LbZ7777777/ECE_1895_Bop-It_Project/README.md

ECE 1895 Junior Design Coursework for the University of Pittsburgh
Bop-it Project
