LbZ7777777/ECE_1895_Bop-It_Project/4-12-2025 Enclosure Design/Speaker Mount-Body.stl

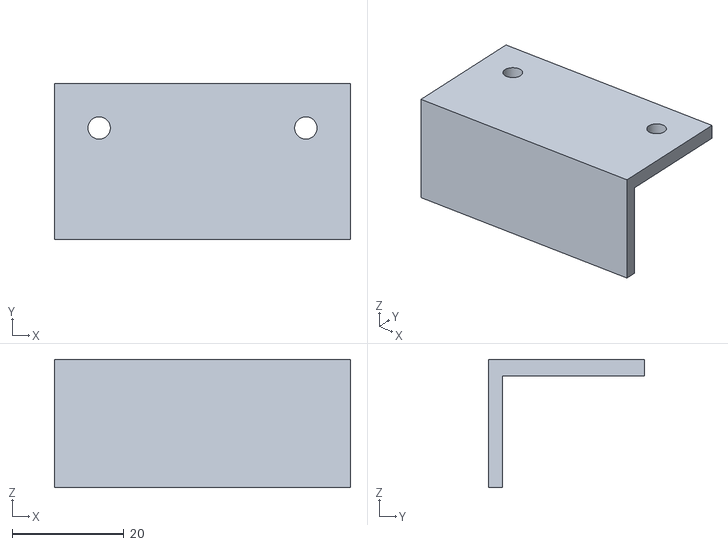
[picture p4: CAD file, 2025-04-13]
4-12-2025 Enclosure Design/Speaker Mount-Body.stl
53.0 x 28.0 x 23.0
