LbZ7777777/ECE_1895_Bop-It_Project/4-12-2025 Enclosure Design/Microphone Mount Taller-Body.stl

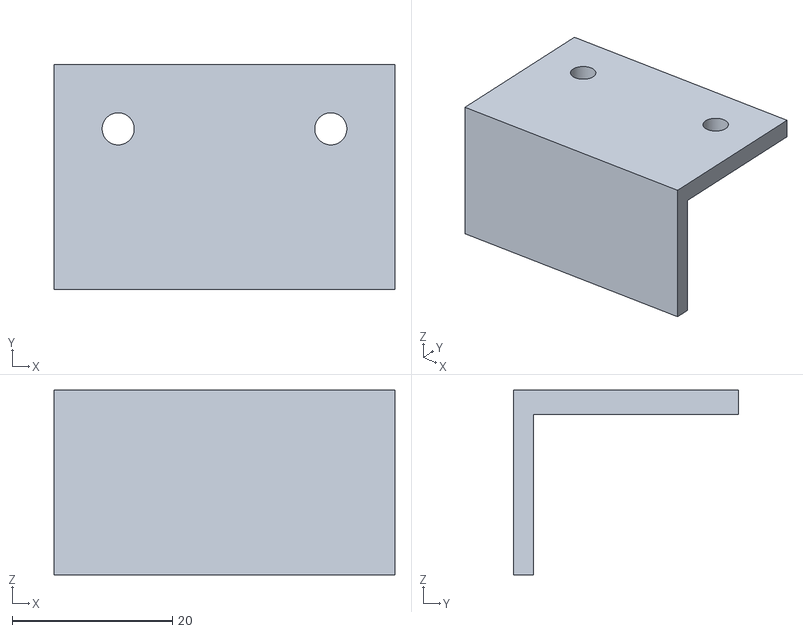
[picture p5: CAD file, 2025-04-13]
4-12-2025 Enclosure Design/Microphone Mount Taller-Body.stl
42.5 x 28.0 x 23.0
