LbZ7777777/ECE_1895_Bop-It_Project/4-12-2025 Enclosure Design/Back Door-Body.stl

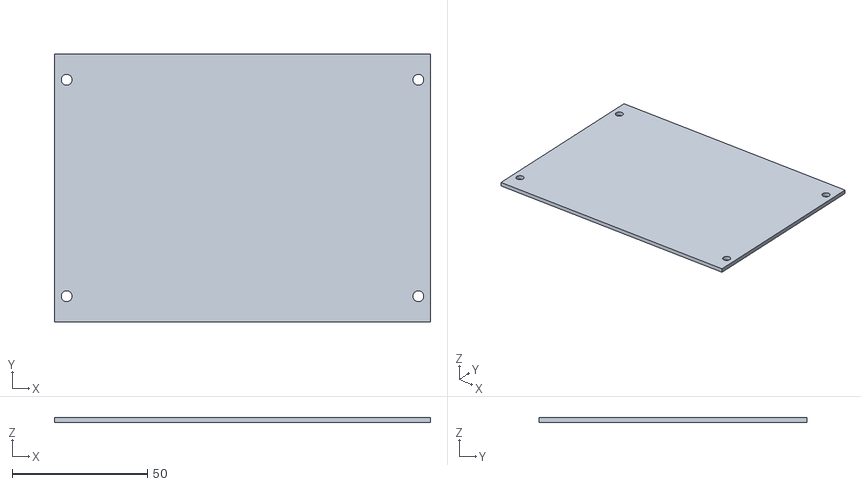
[picture p6: CAD file, 2025-04-13]
4-12-2025 Enclosure Design/Back Door-Body.stl
139.0 x 99.0 x 2.00
