LbZ7777777/ECE_1895_Bop-It_Project/4-12-2025 Enclosure Design/Speaker Mount Wider.FCStd

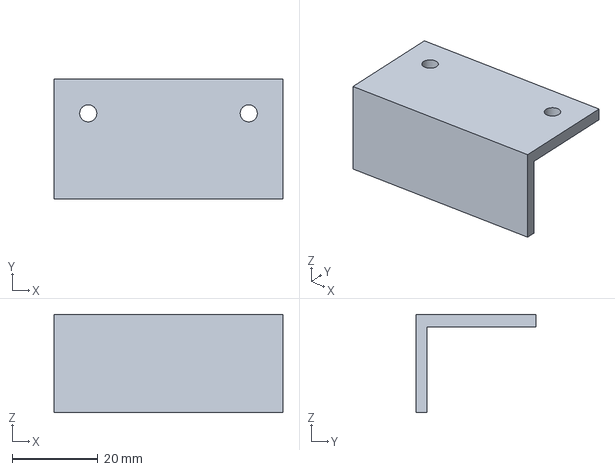
[picture p7: CAD file, 2025-04-13]
4-12-2025 Enclosure Design/Speaker Mount Wider.FCStd
53.5 x 28.0 x 23.0 mm
