LbZ7777777/ECE_1895_Bop-It_Project/4-12-2025 Enclosure Design/Front Panel.FCStd

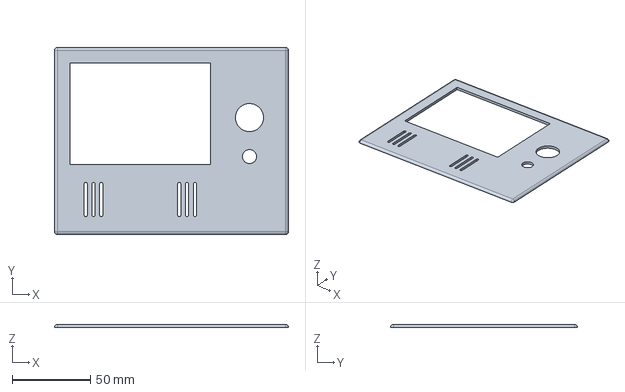
[picture p8: CAD file, 2025-04-13]
4-12-2025 Enclosure Design/Front Panel.FCStd
150.0 x 120.0 x 2.00 mm
