LbZ7777777/ECE_1895_Bop-It_Project/4-12-2025 Enclosure Design/Back Cover.FCStd

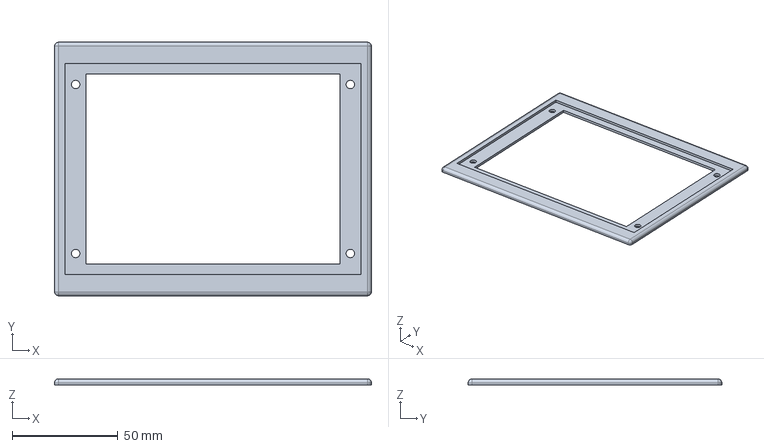
[picture p9: CAD file, 2025-04-13]
4-12-2025 Enclosure Design/Back Cover.FCStd
150.0 x 120.0 x 3.00 mm
