LbZ7777777/ECE_1895_Bop-It_Project/4-12-2025 Enclosure Design/Walls.FCStd

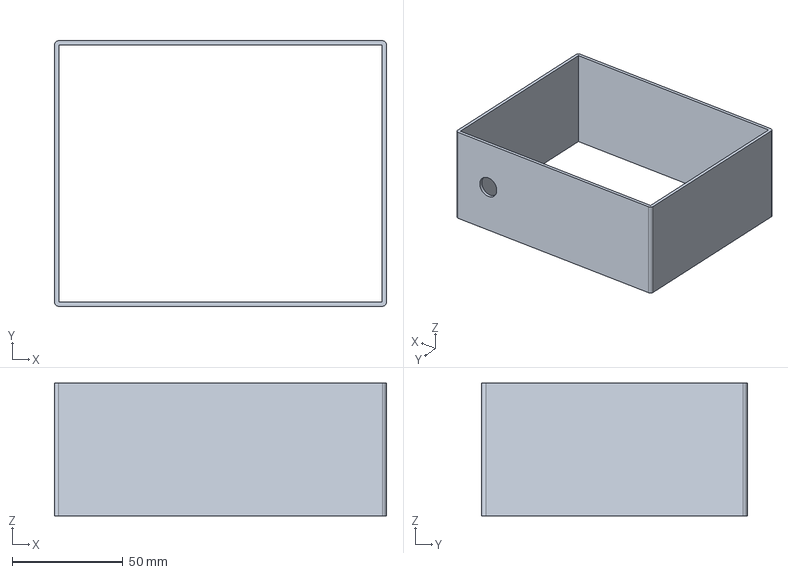
[picture p10: CAD file, 2025-04-13]
4-12-2025 Enclosure Design/Walls.FCStd
150.0 x 120.0 x 60.0 mm
