LbZ7777777/ECE_1895_Bop-It_Project/4-12-2025 Enclosure Design/Microphone Mount.FCStd

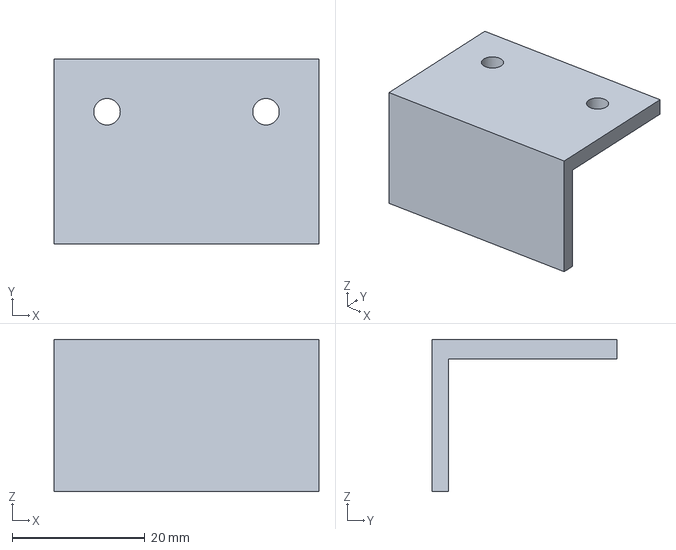
[picture p11: CAD file, 2025-04-13]
4-12-2025 Enclosure Design/Microphone Mount.FCStd
40.0 x 28.0 x 23.0 mm
