LbZ7777777/ECE_1895_Bop-It_Project/4-12-2025 Enclosure Design/Screen Fitting.FCStd

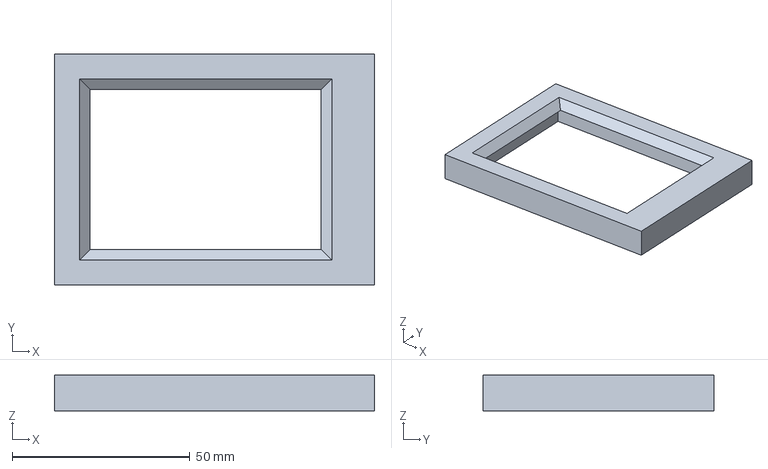
[picture p12: CAD file, 2025-04-13]
4-12-2025 Enclosure Design/Screen Fitting.FCStd
90.0 x 65.0 x 10.0 mm
