LbZ7777777/ECE_1895_Bop-It_Project/4-12-2025 Enclosure Design/Screen Mount.FCStd

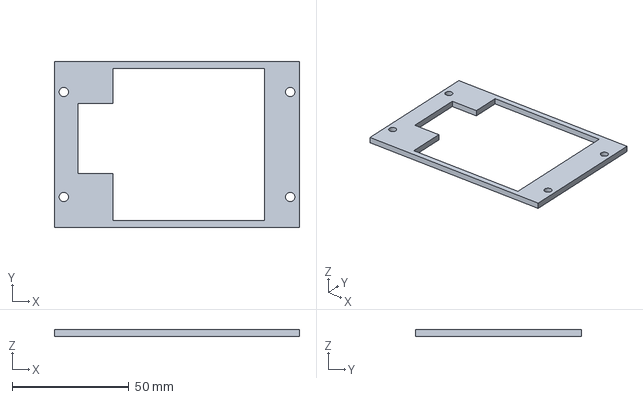
[picture p13: CAD file, 2025-04-13]
4-12-2025 Enclosure Design/Screen Mount.FCStd
105.0 x 71.0 x 3.00 mm
