LbZ7777777/ECE_1895_Bop-It_Project/(list of files, cad)

Other CAD files:
4-12-2025 Enclosure Design/Preview Assembly.FCStd
4-12-2025 Enclosure Design/Speaker Mount.FCStd
4-12-2025 Enclosure Design/Microphone Mount Taller.FCStd
4-12-2025 Enclosure Design/Speaker Mount Wider-Body.stl
4-12-2025 Enclosure Design/Upper Body Asembly.FCStd
4-12-2025 Enclosure Design/Back Door.FCStd
4-12-2025 Enclosure Design/Back Cover-Body.stl
4-12-2025 Enclosure Design/Microphone Mount-Body.stl
4-12-2025 Enclosure Design/Screen Mount-Body.stl
