LbZ7777777/ECE_1895_Bop-It_Project/Tests/FullIntegrationTestMaster/Full Integration Test Cicuit Diagram.png

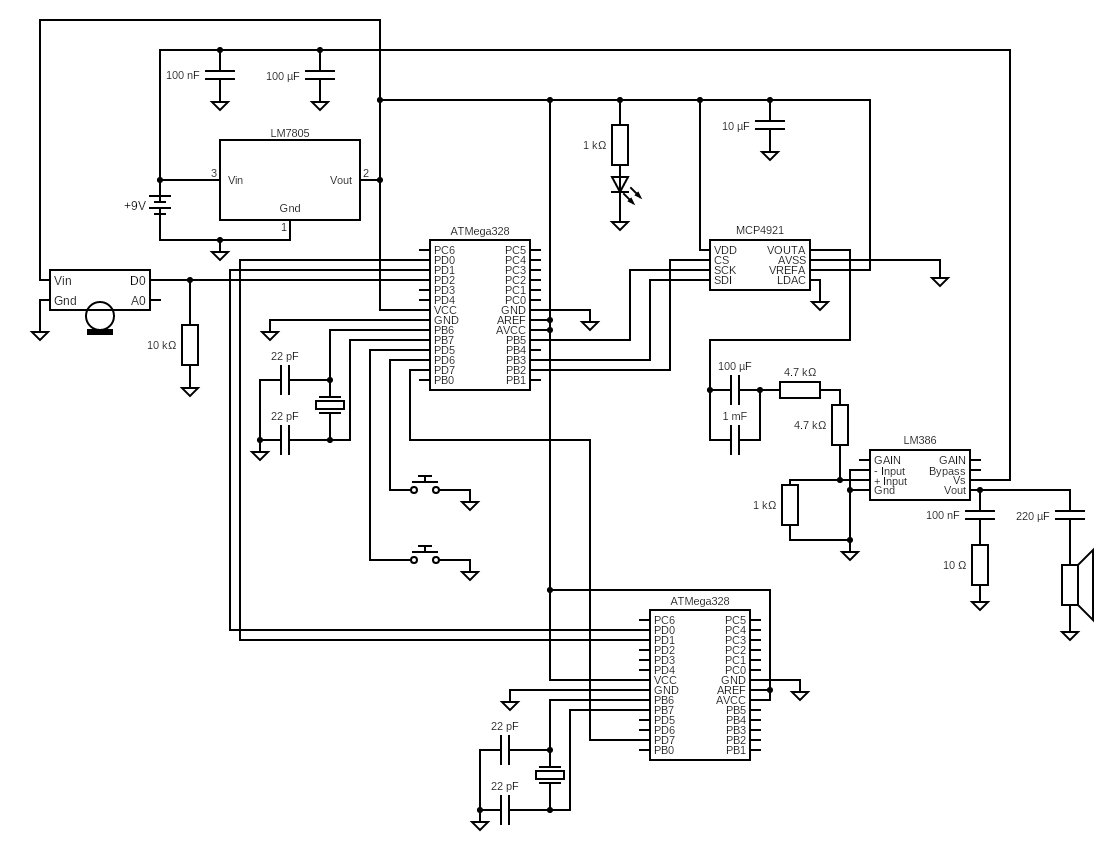
Tests/FullIntegrationTestMaster/Full Integration Test Cicuit Diagram.png
