LbZ7777777/ECE_1895_Bop-It_Project/Tests/SpeakerMicButtonsIntegrationTest/Speaker Mic Buttons Integration Test Circuit Diagram.png

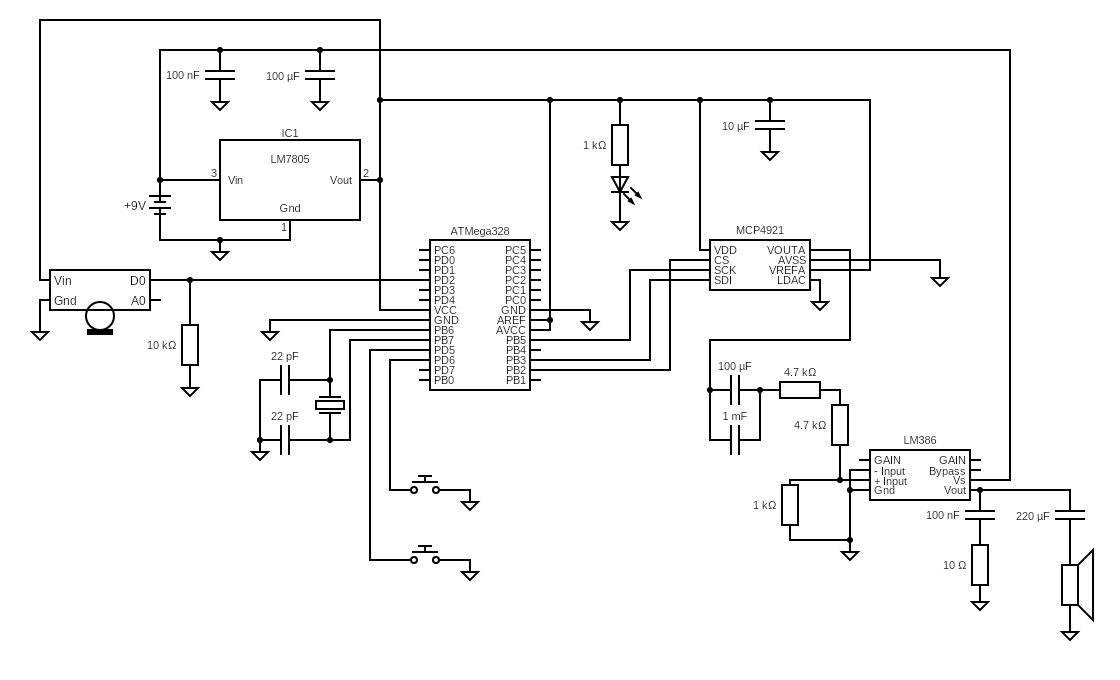
Tests/SpeakerMicButtonsIntegrationTest/Speaker Mic Buttons Integration Test Circuit Diagram.png
