LbZ7777777/ECE_1895_Bop-It_Project/Tests/SpeakerUnitTest/Speaker Unit Test Circuit Diagram.png

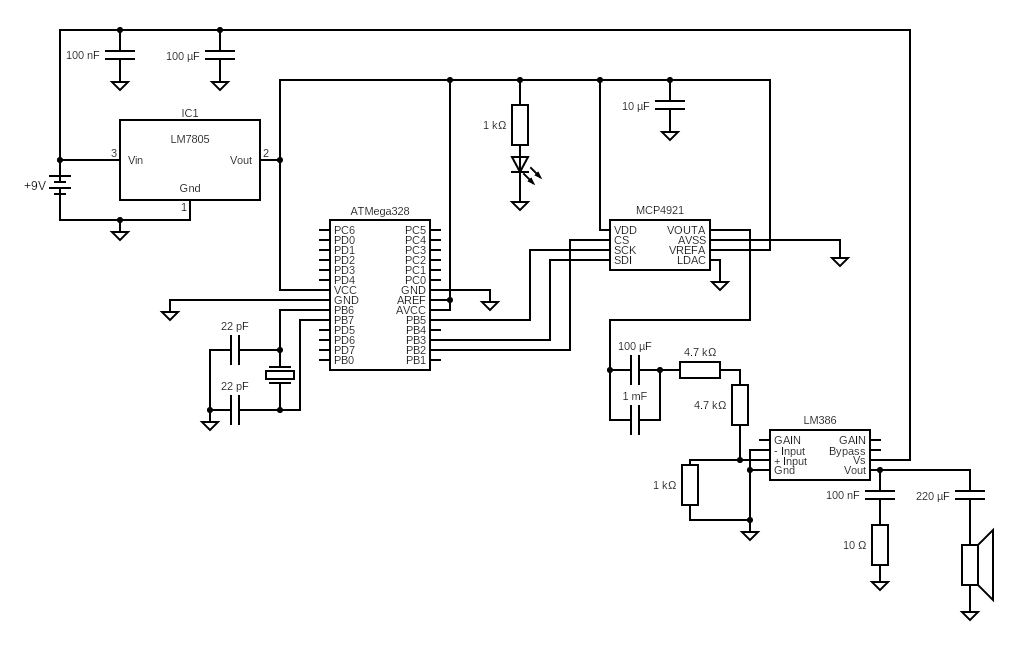
Tests/SpeakerUnitTest/Speaker Unit Test Circuit Diagram.png
