LbZ7777777/ECE_1895_Bop-It_Project/Tests/FullIntegrationTestMaster/roar.h

const unsigned char roarSound[] PROGMEM = {
    128, 128, 128, 128, 127, 128, 128, 128, 128, 128, 128, 127, 128, 127, 128, 127, 128, 128, 128, 127, 128, 127, 127, 128, 127, 128, 127, 127, 128, 128, 128, 128, 127, 128, 128, 127, 127, 128, 127, 128, 127, 128, 127, 128, 128, 128, 128, 128, 128, 128, 128, 128, 128, 127, 128, 127, 128, 127, 128, 127, 128, 127, 128, 128, 128, 128, 128, 128, 128, 128, 128, 128, 128, 128, 128, 128, 128, 128, 128, 128, 128, 128, 128, 128, 127, 128, 127, 128, 127, 128, 127, 127, 127, 127, 127, 127, 128, 127, 128, 127, 128, 127, 127, 128, 127, 128, 128, 128, 128, 128, 128, 128, 128, 128, 128, 128, 128, 128, 128, 128, 128, 128, 127, 128, 127, 128, 127, 127, 127, 127, 128, 127, 128, 127, 128, 127, 128, 127, 128, 128, 128, 128, 128, 128, 128, 128, 128, 127, 127, 128, 127, 128, 127, 127, 128, 128, 127, 128, 127, 128, 127, 127, 127, 127, 127, 127, 127, 127, 127, 127, 127, 127, 127, 127, 127, 127, 127, 127, 127, 127, 127, 127, 128, 127, 127, 127, 127, 128, 127, 128, 128, 128, 128, 128, 128, 128, 128, 128, 128, 128, 128, 128, 128, 128, 128, 128, 128, 128, 128, 128, 128, 128, 128, 128, 128, 128, 128, 128, 128, 128, 127, 127, 127, 127, 127, 127, 127, 127, 127, 127, 127, 127, 127, 127, 127, 127, 127, 127, 127, 127, 127, 127, 127, 127, 128, 128, 128, 128, 128, 128, 128, 128, 128, 128, 128, 128, 128, 128, 128, 128, 128, 128, 128, 128, 128, 128, 128, 128, 128, 128, 128, 128, 128, 128, 128, 128, 128, 128, 128, 128, 128, 128, 128, 127, 127, 127, 127, 127, 126, 126, 126, 126, 126, 126, 125, 125, 125, 125, 126, 1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
, 127, 127, 128, 127, 127, 127, 127, 127, 127, 127, 127, 127, 127, 128, 127, 127, 127, 127, 128, 127, 127
};
const unsigned int roarSound_len = 4923;
