LbZ7777777/ECE_1895_Bop-It_Project/Tests/FullIntegrationTestMaster/tap.h

const unsigned char tapSound[] PROGMEM = {
    127, 127, 127, 127, 127, 127, 127, 127, 127, 127, 127, 127, 127, 127, 127, 127, 127, 127, 127, 127, 127, 127, 127, 127, 127, 127, 128, 127, 128, 127, 127, 128, 127, 128, 128, 127, 128, 128, 128, 128, 127, 127, 127, 128, 127, 127, 127, 127, 127, 127, 127, 127, 127, 127, 128, 127, 128, 128, 128, 128, 128, 128, 128, 128, 127, 127, 128, 128, 128, 127, 128, 127, 128, 127, 127, 128, 128, 128, 127, 127, 127, 127, 127, 127, 127, 127, 128, 128, 127, 127, 127, 128, 127, 127, 128, 127, 127, 127, 128, 128, 128, 127, 128, 128, 128, 128, 127, 127, 127, 128, 127, 128, 127, 127, 127, 127, 128, 128, 128, 127, 128, 128, 128, 127, 127, 128, 128, 127, 127, 127, 128, 128, 127, 128, 128, 128, 128, 128, 128, 128, 128, 128, 128, 128, 127, 127, 128, 127, 127, 127, 127, 127, 127, 127, 127, 128, 128, 128, 128, 128, 128, 127, 127, 127, 127, 127, 127, 127, 127, 128, 127, 127, 127, 127, 127, 127, 127, 127, 128, 127, 127, 128, 128, 127, 127, 127, 127, 128, 128, 128, 127, 127, 127, 128, 127, 128, 128, 128, 127, 127, 127, 127, 128, 127, 128, 128, 128, 127, 128, 127, 128, 127, 127, 127, 128, 127, 127, 127, 128, 128, 128, 128, 128, 128, 128, 128, 127, 127, 127, 127, 127, 127, 128, 127, 127, 128, 128, 128, 128, 128, 128, 128, 127, 127, 127, 127, 127, 127, 127, 128, 128, 127, 127, 128, 128, 128, 127, 128, 128, 128, 127, 127, 128, 128, 127, 127, 128, 128, 127, 127, 128, 128, 128, 127, 127, 128, 128, 127, 127, 128, 128, 127, 127, 127, 128, 128, 127, 127, 128, 128, 127, 127, 128, 128, 128, 127, 127, 128, 128, 1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
};
const unsigned int tapSound_len = 2972;
