LbZ7777777/ECE_1895_Bop-It_Project/(commit log)

2025-03-25 Added circuit diagram for speaker
2025-04-01 Add FreeCad project files
    Design sketch; most parameters not yet finalized.
    [Assembly.FCStd, Back Cover.FCStd, Front Panel.FCStd, Walls.FCStd]
2025-04-01 Add template for screenhousing
    [Screen Fitting.FCStd]
2025-04-04 Update 3D files
    [Back Cover-Body.stl, Back Cover.FCStd, Front Panel-Body.stl, Front Panel-BodyPocket008.stl, Front Panel.FCStd, Screen Fitting-Body.stl, Screen Fitting-BodySubtractiveLoft.stl, Screen Fitting.FCStd]
2025-04-12 Added Testing Files and Circuit Diagrams for Unit and Integration Tests
2025-04-13 Add updated enclosure model
    [Back Cover-Body.stl, Back Cover.FCStd, Back Door-Body.stl, Back Door.FCStd, Front Panel.FCStd, Microphone Mount Taller-Body.stl, Microphone Mount Taller.FCStd, Microphone Mount-Body.stl]
2025-04-13 Delete 4-1-2025 Enclosure Design directory
    remove outdated 3d models
    [Assembly.FCStd, Back Cover-Body.stl, Back Cover.FCStd, Front Panel-Body.stl, Front Panel-BodyPocket008.stl, Front Panel.FCStd, Screen Fitting-Body.stl, Screen Fitting-BodySubtractiveLoft.stl]
